dededecline/SST80/Production Files/README.md

# Production
- Files ready for jlcpcb production.
- Choose between USB or Daughterboard version, same gerber zip for both.
- USB Version has EZmate connector for UDB C4 and S1, DB Version only has JST connector for UDB C3 or equivalents.
