dededecline/SST80/KiCad Project Files/MCU.kicad_sch

## KiCad design KiCad Project Files/MCU.kicad_sch (2023-02-09)

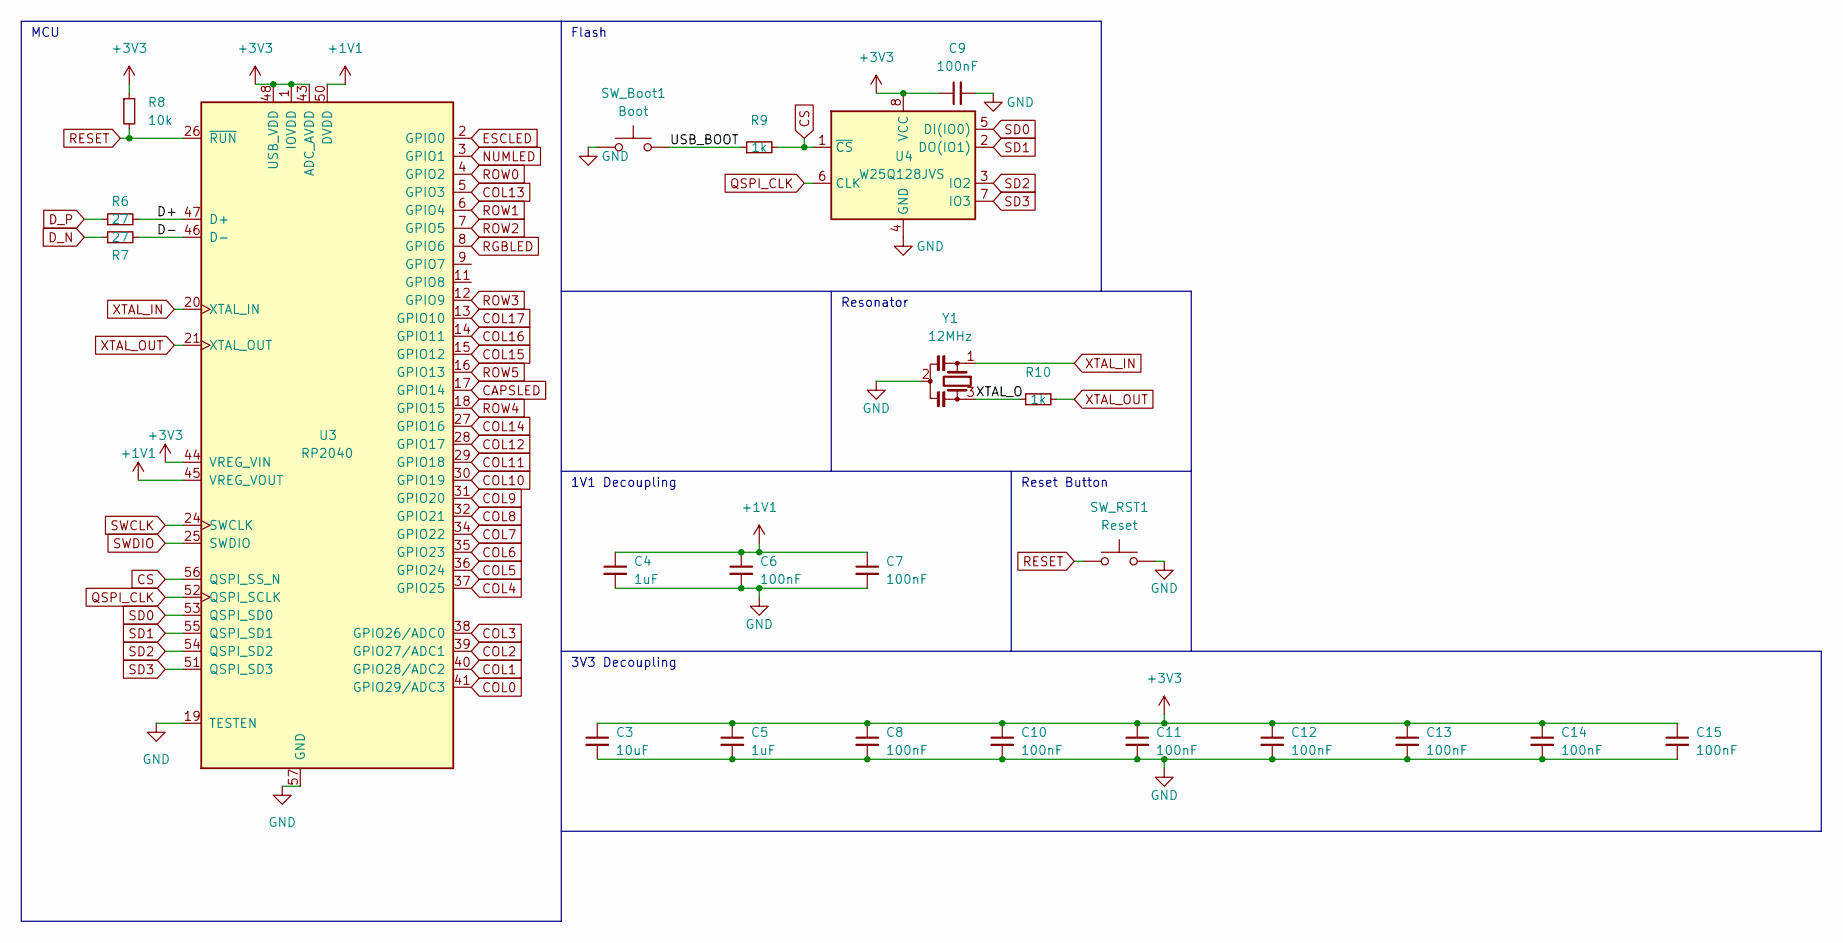
[picture p2: schematic MCU.kicad_sch]

Parts:
C3: 10uF; C_0402_1005Metric
C4, C5: 1uF; C_0402_1005Metric
C6, C7, C8, C9, C10, C11, C12, C13, C14, C15: 100nF; C_0402_1005Metric
R6, R7: 27; R_0402_1005Metric
R8: 10k; R_0402_1005Metric
R9, R10: 1k; R_0402_1005Metric
SW_Boot1: Boot; SW_SPST_TL3342
SW_RST1: Reset; SW_SPST_TL3342
U3: RP2040; RP2040-QFN-56
U4: W25Q128JVS; SOIC-8_5.23x5.23mm_P1.27mm
Y1: 12MHz; Resonator_SMD_Murata_CSTxExxV-3Pin_3.0x1.1mm

Connections:
+1V1: C4.1, C6.1, C7.1, U3.23 (DVDD), U3.45 (VREG_VOUT), U3.50 (DVDD)
+3V3: C3.1, C5.1, C8.1, C9.1, C10.1, C11.1, C12.1, C13.1, C14.1, C15.1, R8.1, U3.1 (IOVDD), U3.10 (IOVDD), U3.22 (IOVDD), U3.33 (IOVDD), U3.42 (IOVDD), U3.43 (ADC_AVDD), U3.44 (VREG_VIN), U3.48 (USB_VDD), U3.49 (IOVDD), U4.8 (VCC)
CAPSLED: U3.17 (GPIO14)
COL0: U3.41 (GPIO29/ADC3)
COL1: U3.40 (GPIO28/ADC2)
COL2: U3.39 (GPIO27/ADC1)
COL3: U3.38 (GPIO26/ADC0)
COL4: U3.37 (GPIO25)
COL5: U3.36 (GPIO24)
COL6: U3.35 (GPIO23)
COL7: U3.34 (GPIO22)
COL8: U3.32 (GPIO21)
COL9: U3.31 (GPIO20)
COL10: U3.30 (GPIO19)
COL11: U3.29 (GPIO18)
COL12: U3.28 (GPIO17)
COL13: U3.5 (GPIO3)
COL14: U3.27 (GPIO16)
COL15: U3.15 (GPIO12)
COL16: U3.14 (GPIO11)
COL17: U3.13 (GPIO10)
CS: R9.2, U3.56 (QSPI_SS_N), U4.1 (~CS)
D+: R6.2, U3.47 (D+)
D-: R7.2, U3.46 (D-)
D_N: R7.1
D_P: R6.1
ESCLED: U3.2 (GPIO0)
GND: C3.2, C4.2, C5.2, C6.2, C7.2, C8.2, C9.2, C10.2, C11.2, C12.2, C13.2, C14.2, C15.2, SW_Boot1.1, SW_RST1.2, U3.19 (TESTEN), U3.57 (GND), U4.4 (GND), Y1.2
NUMLED: U3.3 (GPIO1)
QSPI_CLK: U3.52 (QSPI_SCLK), U4.6 (CLK)
RESET: R8.2, SW_RST1.1, U3.26 (~RUN)
RGBLED: U3.8 (GPIO6)
ROW0: U3.4 (GPIO2)
ROW1: U3.6 (GPIO4)
ROW2: U3.7 (GPIO5)
ROW3: U3.12 (GPIO9)
ROW4: U3.18 (GPIO15)
ROW5: U3.16 (GPIO13)
SD0: U3.53 (QSPI_SD0), U4.5 (DI(IO0))
SD1: U3.55 (QSPI_SD1), U4.2 (DO(IO1))
SD2: U3.54 (QSPI_SD2), U4.3 (IO2)
SD3: U3.51 (QSPI_SD3), U4.7 (IO3)
SWCLK: U3.24 (SWCLK)
SWDIO: U3.25 (SWDIO)
USB_BOOT: R9.1, SW_Boot1.2
XTAL_IN: U3.20 (XTAL_IN), Y1.1
XTAL_O: R10.1, Y1.3
XTAL_OUT: R10.2, U3.21 (XTAL_OUT)

Notes on the sheet:
Flash
1V1 Decoupling
3V3 Decoupling
Reset Button
MCU
Resonator
