dededecline/SST80/KiCad Project Files/Matrix.kicad_sch

## KiCad design KiCad Project Files/Matrix.kicad_sch (2023-02-09)

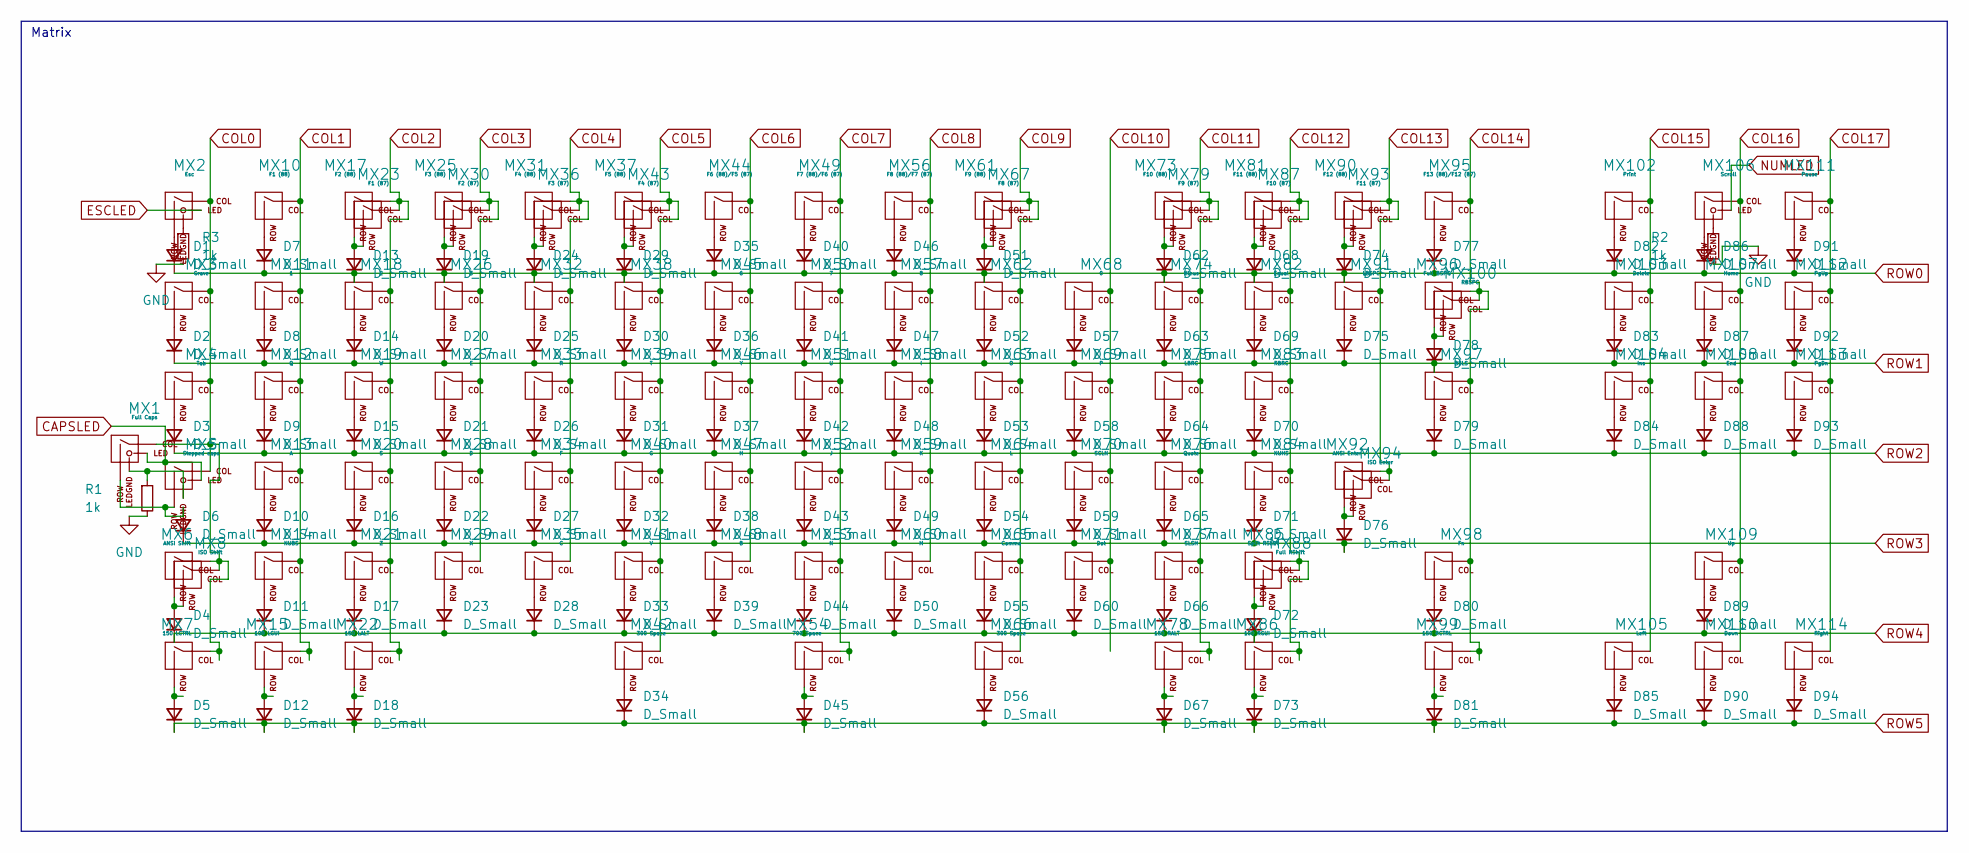
[picture p3: schematic Matrix.kicad_sch]

Parts:
D1, D2, D3, D4, D5, D6, D7, D8, D9, D10, D11, D12, D13, D14, D15, D16, D17, D18, D19, D20, D21, D22, D23, D24, D25, D26, D27, D28, D29, D30, D31, D32, D33, D34, D35, D36, D37, D38, D39, D40, D41, D42, D43, D44, D45, D46, D47, D48, D49, D50, D51, D52, D53, D54, D55, D56, D57, D58, D59, D60, D62, D63, D64, D65, D66, D67, D68, D69, D70, D71, D72, D73, D74, D75, D76, D77, D78, D79, D80, D81, D82, D83, D84, D85, D86, D87, D88, D89, D90, D91, D92, D93, D94: D_Small; D_SOD-123
MX1: Full Caps; MX-1.75U
MX2: Esc; MX-1U
MX3: Grave; MX-1U-NoLED
MX4: Tab; MX-1.5U-NoLED
MX5: Stepped caps; MX-1.25U-FLIPPED
MX6: ANSI Shift; MX-2.25U-NoLED
MX7: 150 LCTRL; MX-1.5U-NoLED
MX8: ISO Shift; MX-1.25U-NoLED
MX10: F1 (88); MX-1U-NoLED
MX11: 1; MX-1U-NoLED
MX12: Q; MX-1U-NoLED
MX13: A; MX-1U-NoLED
MX14: NUBS; MX-1U-NoLED
MX15: 100 LGUI; MX-1U-NoLED
MX17: F2 (88); MX-1U-NoLED
MX18: 2; MX-1U-NoLED
MX19: W; MX-1U-NoLED
MX20: S; MX-1U-NoLED
MX21: Z; MX-1U-NoLED
MX22: 150 LALT; MX-1.5U-NoLED
MX23: F1 (87); MX-1U-NoLED
MX25: F3 (88); MX-1U-NoLED
MX26: 3; MX-1U-NoLED
MX27: E; MX-1U-NoLED
MX28: D; MX-1U-NoLED
MX29: X; MX-1U-NoLED
MX30: F2 (87); MX-1U-NoLED
MX31: F4 (88); MX-1U-NoLED
MX32: 4; MX-1U-NoLED
MX33: R; MX-1U-NoLED
MX34: F; MX-1U-NoLED
MX35: C; MX-1U-NoLED
MX36: F3 (87); MX-1U-NoLED
MX37: F5 (88); MX-1U-NoLED
MX38: 5; MX-1U-NoLED
MX39: T; MX-1U-NoLED
MX40: G; MX-1U-NoLED
MX41: V; MX-1U-NoLED
MX42, MX66: 300 Space; MX-3U-ReversedStabilizers-NoLED
MX43: F4 (87); MX-1U-NoLED
MX44: F6 (88)/F5 (87); MX-1U-NoLED
MX45: 6; MX-1U-NoLED
MX46: Y; MX-1U-NoLED
MX47: H; MX-1U-NoLED
MX48: B; MX-1U-NoLED
MX49: F7 (88)/F6 (87); MX-1U-NoLED
MX50: 7; MX-1U-NoLED
MX51: U; MX-1U-NoLED
MX52: J; MX-1U-NoLED
MX53: N; MX-1U-NoLED
MX54: 700 Space; MX-7U-ReversedStabilizers-NoLED
MX56: F8 (88)/F7 (87); MX-1U-NoLED
MX57: 8; MX-1U-NoLED
MX58: I; MX-1U-NoLED
MX59: K; MX-1U-NoLED
MX60: M; MX-1U-NoLED
MX61: F9 (88); MX-1U-NoLED
MX62: 9; MX-1U-NoLED
MX63: O; MX-1U-NoLED
MX64: L; MX-1U-NoLED
MX65: Comma; MX-1U-NoLED
MX67: F8 (87); MX-1U-NoLED
MX68: 0; MX-1U-NoLED
MX69: P; MX-1U-NoLED
MX70: SCLN; MX-1U-NoLED
MX71: Dot; MX-1U-NoLED
MX73: F10 (88); MX-1U-NoLED
MX74: Minus; MX-1U-NoLED
MX75: LBRC; MX-1U-NoLED
MX76: Quote; MX-1U-NoLED
MX77: SLSH; MX-1U-NoLED
MX78: 150 RALT; MX-1.5U-NoLED
MX79: F9 (87); MX-1U-NoLED
MX81: F11 (88); MX-1U-NoLED
MX82: Equal; MX-1U-NoLED
MX83: RBRC; MX-1U-NoLED
MX84: NUHS; MX-1U-NoLED
MX85: Split RShift; MX-1.75U-NoLED
MX86: 100 RGUI; MX-1U-NoLED
MX87: F10 (87); MX-1U-NoLED
MX88: Full RShift; MX-2.75U-NoLED
MX90: F12 (88); MX-1U-NoLED
MX91: LBSPC; MX-1U-NoLED
MX92: ANSI Enter; MX-2.25U-ReversedStabilizers-NoLED
MX93: F11 (87); MX-1U-NoLED
MX94: ISO Enter; MX-ISO-FLIPPED-ReversedStabilizers
MX95: F13 (88)/F12 (87); MX-1U-NoLED
MX96: Full BSPC; MX-2U-NoLED
MX97: BSLS; MX-1.5U-NoLED
MX98: Fn; MX-1U-NoLED
MX99: 150 RCTRL; MX-1.5U-NoLED
MX100: RBSPC; MX-1U-NoLED
MX102: Print; MX-1U-NoLED
MX103: Delete; MX-1U-NoLED
MX104: Ins; MX-1U-NoLED
MX105: Left; MX-1U-NoLED
MX106: Scroll; MX-1U
MX107: Home; MX-1U-NoLED
MX108: End; MX-1U-NoLED
MX109: Up; MX-1U-NoLED
MX110: Down; MX-1U-NoLED
MX111: Pause; MX-1U-NoLED
MX112: PgUp; MX-1U-NoLED
MX113: PgDn; MX-1U-NoLED
MX114: Right; MX-1U-NoLED
R1, R2, R3: 1k; R_0402_1005Metric

Connections:
CAPSLED: MX1.3 (LED), MX5.3 (LED)
COL0: MX1.1 (COL), MX2.1 (COL), MX3.1 (COL), MX4.1 (COL), MX5.2 (COL), MX6.1 (COL), MX7.1 (COL), MX8.1 (COL)
COL1: MX10.1 (COL), MX11.1 (COL), MX12.1 (COL), MX13.1 (COL), MX14.1 (COL), MX15.1 (COL)
COL2: MX17.1 (COL), MX18.1 (COL), MX19.1 (COL), MX20.1 (COL), MX21.1 (COL), MX22.1 (COL), MX23.2 (COL)
COL3: MX25.1 (COL), MX26.1 (COL), MX27.1 (COL), MX28.1 (COL), MX29.1 (COL), MX30.2 (COL)
COL4: MX31.1 (COL), MX32.1 (COL), MX33.1 (COL), MX34.1 (COL), MX35.1 (COL), MX36.2 (COL)
COL5: MX37.1 (COL), MX38.1 (COL), MX39.1 (COL), MX40.1 (COL), MX41.1 (COL), MX42.1 (COL), MX43.1 (COL)
COL6: MX44.1 (COL), MX45.1 (COL), MX46.1 (COL), MX47.1 (COL), MX48.1 (COL)
COL7: MX49.1 (COL), MX50.1 (COL), MX51.1 (COL), MX52.1 (COL), MX53.1 (COL), MX54.1 (COL)
COL8: MX56.1 (COL), MX57.1 (COL), MX58.1 (COL), MX59.1 (COL), MX60.1 (COL)
COL9: MX61.1 (COL), MX62.1 (COL), MX63.1 (COL), MX64.1 (COL), MX65.1 (COL), MX66.1 (COL), MX67.2 (COL)
COL10: MX68.1 (COL), MX69.1 (COL), MX70.1 (COL), MX71.1 (COL)
COL11: MX73.2 (COL), MX74.1 (COL), MX75.1 (COL), MX76.1 (COL), MX77.1 (COL), MX78.1 (COL), MX79.1 (COL)
COL12: MX81.2 (COL), MX82.1 (COL), MX83.1 (COL), MX84.1 (COL), MX85.1 (COL), MX86.1 (COL), MX87.1 (COL), MX88.1 (COL)
COL13: MX90.2 (COL), MX91.1 (COL), MX92.1 (COL), MX93.1 (COL), MX94.1 (COL)
COL14: MX95.1 (COL), MX96.1 (COL), MX97.1 (COL), MX98.1 (COL), MX99.1 (COL), MX100.1 (COL)
COL15: MX102.1 (COL), MX103.1 (COL), MX104.1 (COL), MX105.1 (COL)
COL16: MX106.1 (COL), MX107.1 (COL), MX108.1 (COL), MX109.1 (COL), MX110.1 (COL)
COL17: MX111.1 (COL), MX112.1 (COL), MX113.1 (COL), MX114.1 (COL)
ESCLED: MX2.3 (LED)
GND: R1.2, R2.2, R3.2
NUMLED: MX106.3 (LED)
unnamed: D1.2 (A), MX2.2 (ROW)
unnamed: D2.2 (A), MX3.2 (ROW)
unnamed: D3.2 (A), MX4.2 (ROW)
unnamed: D4.2 (A), MX6.2 (ROW), MX8.2 (ROW)
unnamed: D5.2 (A), MX7.2 (ROW)
unnamed: D6.2 (A), MX1.2 (ROW), MX5.1 (ROW)
unnamed: D7.2 (A), MX10.2 (ROW)
unnamed: D8.2 (A), MX11.2 (ROW)
unnamed: D9.2 (A), MX12.2 (ROW)
unnamed: D10.2 (A), MX13.2 (ROW)
unnamed: D11.2 (A), MX14.2 (ROW)
unnamed: D12.2 (A), MX15.2 (ROW)
unnamed: D13.2 (A), MX17.2 (ROW), MX23.1 (ROW)
unnamed: D14.2 (A), MX18.2 (ROW)
unnamed: D15.2 (A), MX19.2 (ROW)
unnamed: D16.2 (A), MX20.2 (ROW)
unnamed: D17.2 (A), MX21.2 (ROW)
unnamed: D18.2 (A), MX22.2 (ROW)
unnamed: D19.2 (A), MX25.2 (ROW), MX30.1 (ROW)
unnamed: D20.2 (A), MX26.2 (ROW)
unnamed: D21.2 (A), MX27.2 (ROW)
unnamed: D22.2 (A), MX28.2 (ROW)
unnamed: D23.2 (A), MX29.2 (ROW)
unnamed: D24.2 (A), MX31.2 (ROW), MX36.1 (ROW)
unnamed: D25.2 (A), MX32.2 (ROW)
unnamed: D26.2 (A), MX33.2 (ROW)
unnamed: D27.2 (A), MX34.2 (ROW)
unnamed: D28.2 (A), MX35.2 (ROW)
unnamed: D29.2 (A), MX37.2 (ROW), MX43.2 (ROW)
unnamed: D30.2 (A), MX38.2 (ROW)
unnamed: D31.2 (A), MX39.2 (ROW)
unnamed: D32.2 (A), MX40.2 (ROW)
unnamed: D33.2 (A), MX41.2 (ROW)
unnamed: D34.2 (A), MX42.2 (ROW)
unnamed: D35.2 (A), MX44.2 (ROW)
unnamed: D36.2 (A), MX45.2 (ROW)
unnamed: D37.2 (A), MX46.2 (ROW)
unnamed: D38.2 (A), MX47.2 (ROW)
unnamed: D39.2 (A), MX48.2 (ROW)
unnamed: D40.2 (A), MX49.2 (ROW)
unnamed: D41.2 (A), MX50.2 (ROW)
unnamed: D42.2 (A), MX51.2 (ROW)
unnamed: D43.2 (A), MX52.2 (ROW)
unnamed: D44.2 (A), MX53.2 (ROW)
unnamed: D45.2 (A), MX54.2 (ROW)
unnamed: D46.2 (A), MX56.2 (ROW)
unnamed: D47.2 (A), MX57.2 (ROW)
unnamed: D48.2 (A), MX58.2 (ROW)
unnamed: D49.2 (A), MX59.2 (ROW)
unnamed: D50.2 (A), MX60.2 (ROW)
unnamed: D51.2 (A), MX61.2 (ROW), MX67.1 (ROW)
unnamed: D52.2 (A), MX62.2 (ROW)
unnamed: D53.2 (A), MX63.2 (ROW)
unnamed: D54.2 (A), MX64.2 (ROW)
unnamed: D55.2 (A), MX65.2 (ROW)
unnamed: D56.2 (A), MX66.2 (ROW)
unnamed: D57.2 (A), MX68.2 (ROW)
unnamed: D58.2 (A), MX69.2 (ROW)
unnamed: D59.2 (A), MX70.2 (ROW)
unnamed: D60.2 (A), MX71.2 (ROW)
unnamed: D62.2 (A), MX73.1 (ROW), MX79.2 (ROW)
unnamed: D63.2 (A), MX74.2 (ROW)
unnamed: D64.2 (A), MX75.2 (ROW)
unnamed: D65.2 (A), MX76.2 (ROW)
unnamed: D66.2 (A), MX77.2 (ROW)
unnamed: D67.2 (A), MX78.2 (ROW)
unnamed: D68.2 (A), MX81.1 (ROW), MX87.2 (ROW)
unnamed: D69.2 (A), MX82.2 (ROW)
unnamed: D70.2 (A), MX83.2 (ROW)
unnamed: D71.2 (A), MX84.2 (ROW)
unnamed: D72.2 (A), MX85.2 (ROW), MX88.2 (ROW)
unnamed: D73.2 (A), MX86.2 (ROW)
unnamed: D74.2 (A), MX90.1 (ROW), MX93.2 (ROW)
unnamed: D75.2 (A), MX91.2 (ROW)
unnamed: D76.2 (A), MX92.2 (ROW), MX94.2 (ROW)
unnamed: D77.2 (A), MX95.2 (ROW)
unnamed: D78.2 (A), MX96.2 (ROW), MX100.2 (ROW)
unnamed: D79.2 (A), MX97.2 (ROW)
unnamed: D80.2 (A), MX98.2 (ROW)
unnamed: D81.2 (A), MX99.2 (ROW)
unnamed: D82.2 (A), MX102.2 (ROW)
unnamed: D83.2 (A), MX103.2 (ROW)
unnamed: D84.2 (A), MX104.2 (ROW)
unnamed: D85.2 (A), MX105.2 (ROW)
unnamed: D86.2 (A), MX106.2 (ROW)
unnamed: D87.2 (A), MX107.2 (ROW)
unnamed: D88.2 (A), MX108.2 (ROW)
unnamed: D89.2 (A), MX109.2 (ROW)
unnamed: D90.2 (A), MX110.2 (ROW)
unnamed: D91.2 (A), MX111.2 (ROW)
unnamed: D92.2 (A), MX112.2 (ROW)
unnamed: D93.2 (A), MX113.2 (ROW)
unnamed: D94.2 (A), MX114.2 (ROW)
unnamed: MX1.4 (LEDGND), MX5.4 (LEDGND), R1.1
unnamed: MX2.4 (LEDGND), R3.1
unnamed: MX106.4 (LEDGND), R2.1
ROW0: D1.1 (K), D7.1 (K), D13.1 (K), D19.1 (K), D24.1 (K), D29.1 (K), D35.1 (K), D40.1 (K), D46.1 (K), D51.1 (K), D62.1 (K), D68.1 (K), D74.1 (K), D77.1 (K), D82.1 (K), D86.1 (K), D91.1 (K)
ROW1: D2.1 (K), D8.1 (K), D14.1 (K), D20.1 (K), D25.1 (K), D30.1 (K), D36.1 (K), D41.1 (K), D47.1 (K), D52.1 (K), D57.1 (K), D63.1 (K), D69.1 (K), D75.1 (K), D78.1 (K), D83.1 (K), D87.1 (K), D92.1 (K)
ROW2: D3.1 (K), D9.1 (K), D15.1 (K), D21.1 (K), D26.1 (K), D31.1 (K), D37.1 (K), D42.1 (K), D48.1 (K), D53.1 (K), D58.1 (K), D64.1 (K), D70.1 (K), D79.1 (K), D84.1 (K), D88.1 (K), D93.1 (K)
ROW3: D6.1 (K), D10.1 (K), D16.1 (K), D22.1 (K), D27.1 (K), D32.1 (K), D38.1 (K), D43.1 (K), D49.1 (K), D54.1 (K), D59.1 (K), D65.1 (K), D71.1 (K), D76.1 (K)
ROW4: D4.1 (K), D11.1 (K), D17.1 (K), D23.1 (K), D28.1 (K), D33.1 (K), D39.1 (K), D44.1 (K), D50.1 (K), D55.1 (K), D60.1 (K), D66.1 (K), D72.1 (K), D80.1 (K), D89.1 (K)
ROW5: D5.1 (K), D12.1 (K), D18.1 (K), D34.1 (K), D45.1 (K), D56.1 (K), D67.1 (K), D73.1 (K), D81.1 (K), D85.1 (K), D90.1 (K), D94.1 (K)

Notes on the sheet:
Matrix
