dededecline/SST80/KiCad Project Files/Misc.kicad_sch

## KiCad design KiCad Project Files/Misc.kicad_sch (2023-02-09)

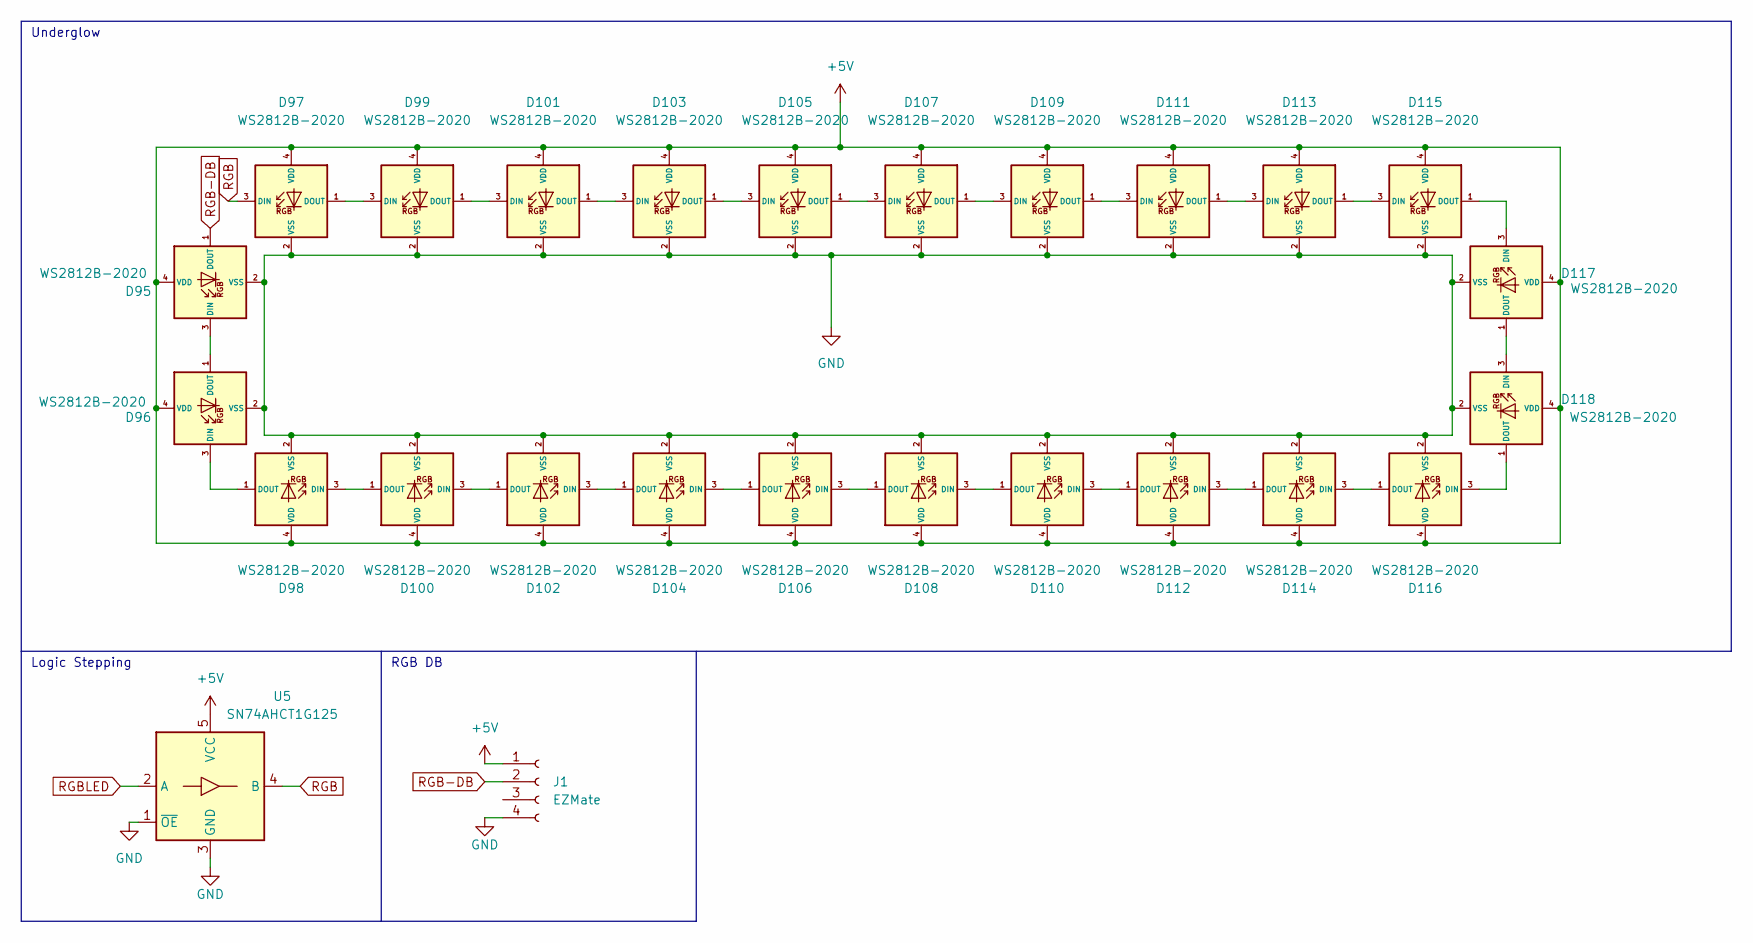
[picture p4: schematic Misc.kicad_sch]

Parts:
D95, D96, D97, D98, D99, D100, D101, D102, D103, D104, D105, D106, D107, D108, D109, D110, D111, D112, D113, D114, D115, D116, D117, D118: WS2812B-2020; LED_WS2812_2020
J1: EZMate; Molex_Pico-EZmate_78171-0004_1x04-1MP_P1.20mm_Vertical
U5: SN74AHCT1G125; SOT-23-5

Connections:
+5V: D95.4 (VDD), D96.4 (VDD), D97.4 (VDD), D98.4 (VDD), D99.4 (VDD), D100.4 (VDD), D101.4 (VDD), D102.4 (VDD), D103.4 (VDD), D104.4 (VDD), D105.4 (VDD), D106.4 (VDD), D107.4 (VDD), D108.4 (VDD), D109.4 (VDD), D110.4 (VDD), D111.4 (VDD), D112.4 (VDD), D113.4 (VDD), D114.4 (VDD), D115.4 (VDD), D116.4 (VDD), D117.4 (VDD), D118.4 (VDD), J1.1, U5.5 (VCC)
GND: D95.2 (VSS), D96.2 (VSS), D97.2 (VSS), D98.2 (VSS), D99.2 (VSS), D100.2 (VSS), D101.2 (VSS), D102.2 (VSS), D103.2 (VSS), D104.2 (VSS), D105.2 (VSS), D106.2 (VSS), D107.2 (VSS), D108.2 (VSS), D109.2 (VSS), D110.2 (VSS), D111.2 (VSS), D112.2 (VSS), D113.2 (VSS), D114.2 (VSS), D115.2 (VSS), D116.2 (VSS), D117.2 (VSS), D118.2 (VSS), J1.4, U5.1 (~OE), U5.3 (GND)
unnamed: D95.3 (DIN), D96.1 (DOUT)
unnamed: D96.3 (DIN), D98.1 (DOUT)
unnamed: D97.1 (DOUT), D99.3 (DIN)
unnamed: D98.3 (DIN), D100.1 (DOUT)
unnamed: D100.3 (DIN), D102.1 (DOUT)
unnamed: D101.1 (DOUT), D103.3 (DIN)
unnamed: D99.1 (DOUT), D101.3 (DIN)
unnamed: D102.3 (DIN), D104.1 (DOUT)
unnamed: D103.1 (DOUT), D105.3 (DIN)
unnamed: D104.3 (DIN), D106.1 (DOUT)
unnamed: D105.1 (DOUT), D107.3 (DIN)
unnamed: D106.3 (DIN), D108.1 (DOUT)
unnamed: D107.1 (DOUT), D109.3 (DIN)
unnamed: D108.3 (DIN), D110.1 (DOUT)
unnamed: D109.1 (DOUT), D111.3 (DIN)
unnamed: D110.3 (DIN), D112.1 (DOUT)
unnamed: D111.1 (DOUT), D113.3 (DIN)
unnamed: D112.3 (DIN), D114.1 (DOUT)
unnamed: D113.1 (DOUT), D115.3 (DIN)
unnamed: D114.3 (DIN), D116.1 (DOUT)
unnamed: D115.1 (DOUT), D117.3 (DIN)
unnamed: D116.3 (DIN), D118.1 (DOUT)
unnamed: D117.1 (DOUT), D118.3 (DIN)
RGB: D97.3 (DIN), U5.4 (B)
RGB-DB: D95.1 (DOUT), J1.2
RGBLED: U5.2 (A)

Notes on the sheet:
Underglow
Logic Stepping
RGB DB
