dededecline/SST80/KiCad Project Files/USB-Power.kicad_sch

## KiCad design KiCad Project Files/USB-Power.kicad_sch (2023-02-09)

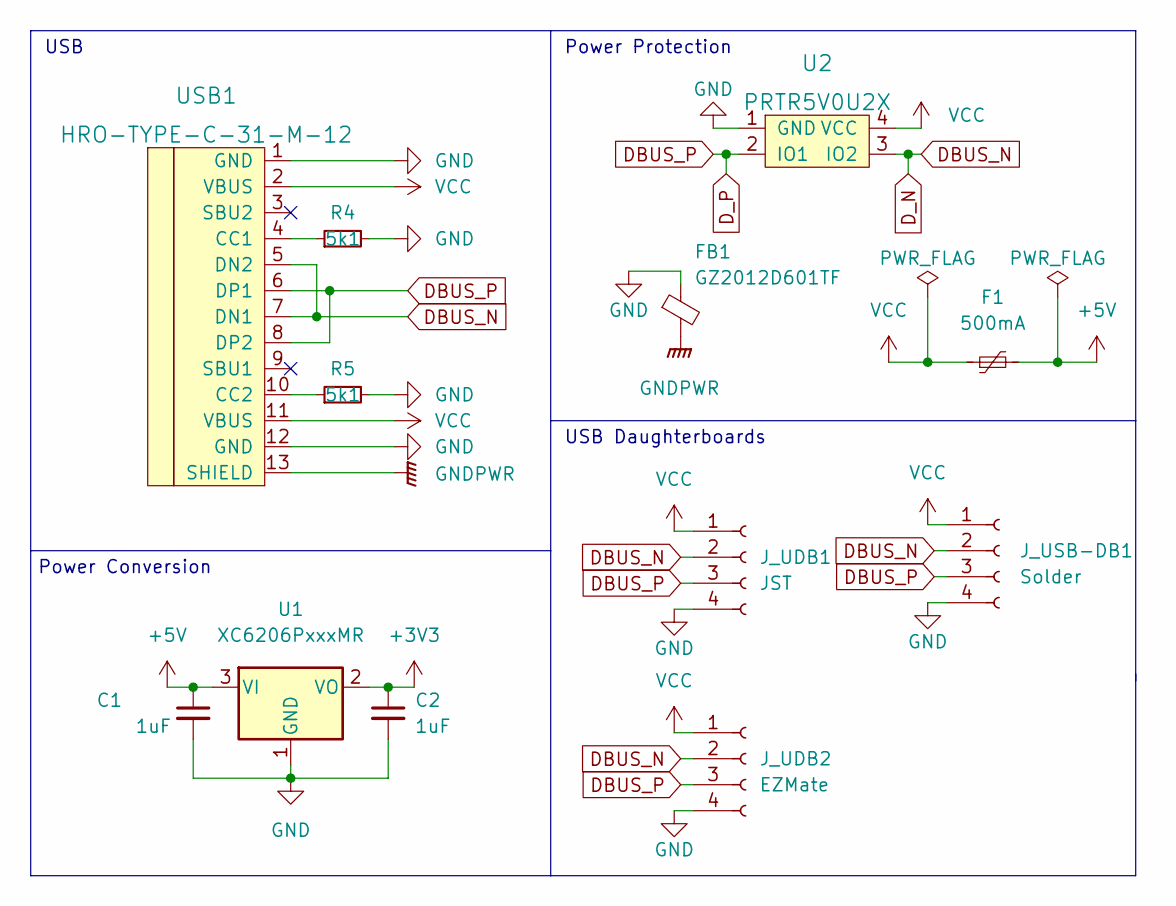
[picture p5: schematic USB-Power.kicad_sch]

Parts:
C1, C2: 1uF; C_0402_1005Metric
F1: 500mA; Fuse_0805_2012Metric
FB1: GZ2012D601TF; L_0805_2012Metric
J_UDB1: JST; JST_SH_SM04B-SRSS-TB_1x04-1MP_P1.00mm_Horizontal
J_UDB2: EZMate; Molex_Pico-EZmate_78171-0004_1x04-1MP_P1.20mm_Vertical
J_USB-DB1: Solder; PinSocket_1x04_P2.54mm_Vertical
R4, R5: 5k1; R_0402_1005Metric
U1: XC6206PxxxMR; SOT-23
U2: PRTR5V0U2X; SOT143B
USB1: HRO-TYPE-C-31-M-12; HRO-TYPE-C-31-M-12-Assembly

Connections:
+3V3: C2.1, U1.2 (VO)
+5V: C1.1, F1.2, U1.3 (VI)
D_N: J_UDB1.2, J_UDB2.2, J_USB-DB1.2, U2.3 (IO2), USB1.5 (DN2), USB1.7 (DN1)
D_P: J_UDB1.3, J_UDB2.3, J_USB-DB1.3, U2.2 (IO1), USB1.6 (DP1), USB1.8 (DP2)
GND: C1.2, C2.2, FB1.1, J_UDB1.4, J_UDB2.4, J_USB-DB1.4, R4.2, R5.2, U1.1 (GND), U2.1 (GND), USB1.1 (GND), USB1.12 (GND)
GNDPWR: FB1.2, USB1.13 (SHIELD)
unnamed: R4.1, USB1.4 (CC1)
unnamed: R5.1, USB1.10 (CC2)
VCC: F1.1, J_UDB1.1, J_UDB2.1, J_USB-DB1.1, U2.4 (VCC), USB1.2 (VBUS), USB1.11 (VBUS)

Notes on the sheet:
Power Conversion
Power Protection
USB Daughterboards
USB
