dededecline/SST80/(threads)

Thread 2 (2023-05-04):

Add version with spacebar stabilizers facing south?

CountKeepo, 2023-05-04:
There was an issue with a user swapping their broken PCB out with one of these SST80's and realizing that the stabilizers faced the opposite of those of the original PCB. Due to this the plate catched onto the stab wires and causes ticking and sticking.

Hineybush seems to now manufacture these PCB's in both North and South facing layouts just for this reason, so maybe there could be a version made with south facing stabilizers?

**I'd also add a disclaimer just in case that makes sure people realize this PCB is currently equivalent to the H87C north facing variant.**

https://hineybush.com/products/h87c

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

ojthetiny, 2023-05-04:
South facing stabilizers are becoming increasingly uncommon but this is a good point if we want to keep this PCB somewhat universal. Will be considered in a future release

Thread 3 (2023-07-29):

Improved support for Alps Caps Lock?

countkrzysztof, 2023-07-29:
Alps keysets frequently use a stepped Caps Lock key with a stepped area of 1.5u, rather than the MX standard of 1.25u stepped area. The current release of this PCB does not support this Caps Lock footprint. Is this something you'd consider adding in a future revision?

_Example Caps Lock footprint from hiney h87c, arrows indicate holes for Alps stepped Caps Lock:_
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
