dededecline/SST80/(commit log)

2023-02-09 initial dump
    [MCU.kicad_sch, Matrix.kicad_sch, Misc.kicad_sch, SST80.kicad_sch, SST80_1.0-JST-BOM.csv, SST80_1.0-USB-BOM.csv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]
2023-02-20 Update ezmate part number
    [SST80_1.0-USB-BOM.csv]
2023-02-23 correct EZmate part number
    [SST80_1.0-JST-BOM.csv]
2023-02-23 remove JST from POS file
    [SST80_1.0-USB-POS.csv]
2023-02-23 add JST to POS
    [SST80_1.0-JST-POS.csv]
2023-06-20 correct gerber files
